Claudia-Pacori/Repositorio_Tesis_Pacori/README.md

# Repositorio de Trabajo de Investigación
Contenido de hardware y firmware para mi trabajo de investigación. 

Nombre: Claudia Pacori Palomino

Universidad de Ingeniería y Tecnología.

Lima, Perú - 2024.2
