Claudia-Pacori/Repositorio_Tesis_Pacori/01 Hardware/00 PCB/Producción/BOM_Tesis_nodo_PS.xlsx

Comment | Part | Footprint | Value | Designator
CC0603KRX7R9BB104 | C14663 | C0603 | 0.1uF | C1
CL10A106KP8NNNC | C19702 | C0603 | 10uF | C2
CC0603KRX7R9BB104 | C14663 | C0603 | 0.1uF | C3
CC0805KRX7R9BB104 | C49678 | C0805 | 0.1uF | C6
CL10A106KP8NNNC | C19702 | C0603 | 10uF | C7
CC0603KRX7R9BB104 | C14663 | C0603 | 0.1uF | C8
CC0603KRX7R9BB104 | C14663 | C0603 | 0.1uF | C11
CL31A106KBHNNNE | C13585 | C1206 | 10uF | C14
CL31A226KPHNNNE | C5672 | C1206 | 22uF | C15
CL10A475KO8NNNC | C19666 | C0603 | 4.7uF | C16
CC0603KRX7R9BB104 | C14663 | C0603 | 0.1uF | C17
CL10A475KO8NNNC | C19666 | C0603 | 4.7uF | C18
YLED0603B | C19171394 | LED-0603 | BLUE | D1
YLED0603B | C19171394 | LED-0603 | BLUE | D2
SS34 | C8678 | DO-214AC | SS34 | D3
PRTR5V0U2F,115 | C478118 | SOT886 | PRTR5V0U2F | D5
SS34 | C8678 | DO-214AC | SS34 | D7
TJ-S1615SW6TGLCCSRGB-A5 | C273611 | LED-0606 | TJ-S1615SW6TGLCCSRGB-A5 | D8
918-418K2023S40001 | C167321 | TYPE-C-SMD | USB-C FemaleConnector | J2
TFM201610ALM-R47MTAA | C501954 | 806 | 470nH | L1
25121WJ010KT4E | C419755 | R2512 | 0.1 | R1
0603WAF1002T5E | C25804 | R0603 | 10k | R2
0603WAF1002T5E | C25804 | R0603 | 10k | R3
0603WAF1002T5E | C25804 | R0603 | 10k | R4
0603WAF1002T5E | C25804 | R0603 | 10k | R5
0603WAF1002T5E | C25804 | R0603 | 10k | R6
0603WAF1503T5E | C22807 | R0603 | 150k | R7
0805W8F1002T5E | C17414 | R0805 | 10k | R9
0603WAF2200T5E | C22962 | R0603 | 220 | R10
0805W8F1002T5E | C17414 | R0805 | 10k | R11
0603WAF2200T5E | C22962 | R0603 | 220 | R12
0603WAF5113T5E | C23194 | R0603 | 511k | R13
0603WAJ0913T5E | C25610 | R0603 | 91k | R14
0603WAF1003T5E | C25803 | R0603 | 100k | R15
0603WAF5101T5E | C23186 | R0603 | 5.1k | R18
0603WAF5101T5E | C23186 | R0603 | 5.1k | R19
0603WAF1201T5E | C22765 | R0603 | 1.2k | R21
0603WAF2200T5E | C22962 | R0603 | 220 | R22
0603WAF2200T5E | C22962 | R0603 | 220 | R23
INA219BIDCNT | C2653868 | SOT23-8 | INA219BIDCNT | SENSORCORRIENTE
SKRKAEE020 | C115357 | SW-SMD-2_2.9x3.9x1.7 | SKRKAEE020 | SW1
SKRKAEE020 | C115357 | SW-SMD-2_2.9x3.9x1.7 | SKRKAEE020 | SW2
AO3401A | C15127 | SOT-23 | AO3401A | T1
SHT40-BD1B-R2 | C7461849 | SHT40BD1BR2 | SHT40-BD1B-R2 | TH
ESP32-WROOM-32E(16MB) | C701343 | ESP-WROOM-32D-NARROW | ESP-WROOM-32E | U2
CH340C | C84681 | SOP-16 | CH340C | U4
LMBT3904DW1T1G | C131781 | SOT-363 | MBT3904DW1T1 | U5
MAX17048G+T10 | C2682616 | TDFN-8_EP | MAX17048 | U7
TPS63802DLAR | C2845237 | VSON-10(2x3) | TPS63802DLAR | U11
TP4056-42-ESOP8 | C16581 | ESOP-8 | TP4056 | U13
