Claudia-Pacori/Repositorio_Tesis_Pacori/01 Hardware/01 Carcasa/Pieza_baja.stl

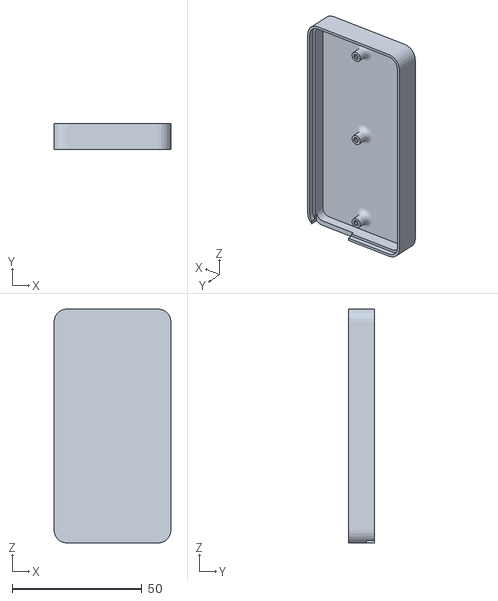
[picture p1: CAD file, 2024-10-21]
01 Hardware/01 Carcasa/Pieza_baja.stl
45.0 x 10.0 x 90.0
