Claudia-Pacori/Repositorio_Tesis_Pacori/01 Hardware/01 Carcasa/Pieza_superior.stl

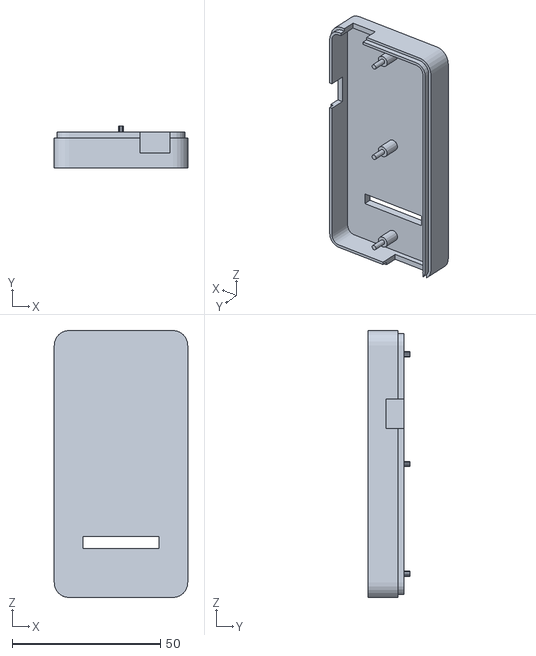
[picture p2: CAD file, 2024-10-21]
01 Hardware/01 Carcasa/Pieza_superior.stl
45.0 x 14.0 x 90.0
