Claudia-Pacori/Repositorio_Tesis_Pacori/(list of files, cad)

Other CAD files:
01 Hardware/01 Carcasa/Pieza_baja.ipt
01 Hardware/01 Carcasa/Pieza_superior.ipt
