Claudia-Pacori/Repositorio_Tesis_Pacori/01 Hardware/00 PCB/nodos_schematic.pdf

# TFM201610ALM-R47MTAA ADC¹ ADC² Boot Control

## VIN

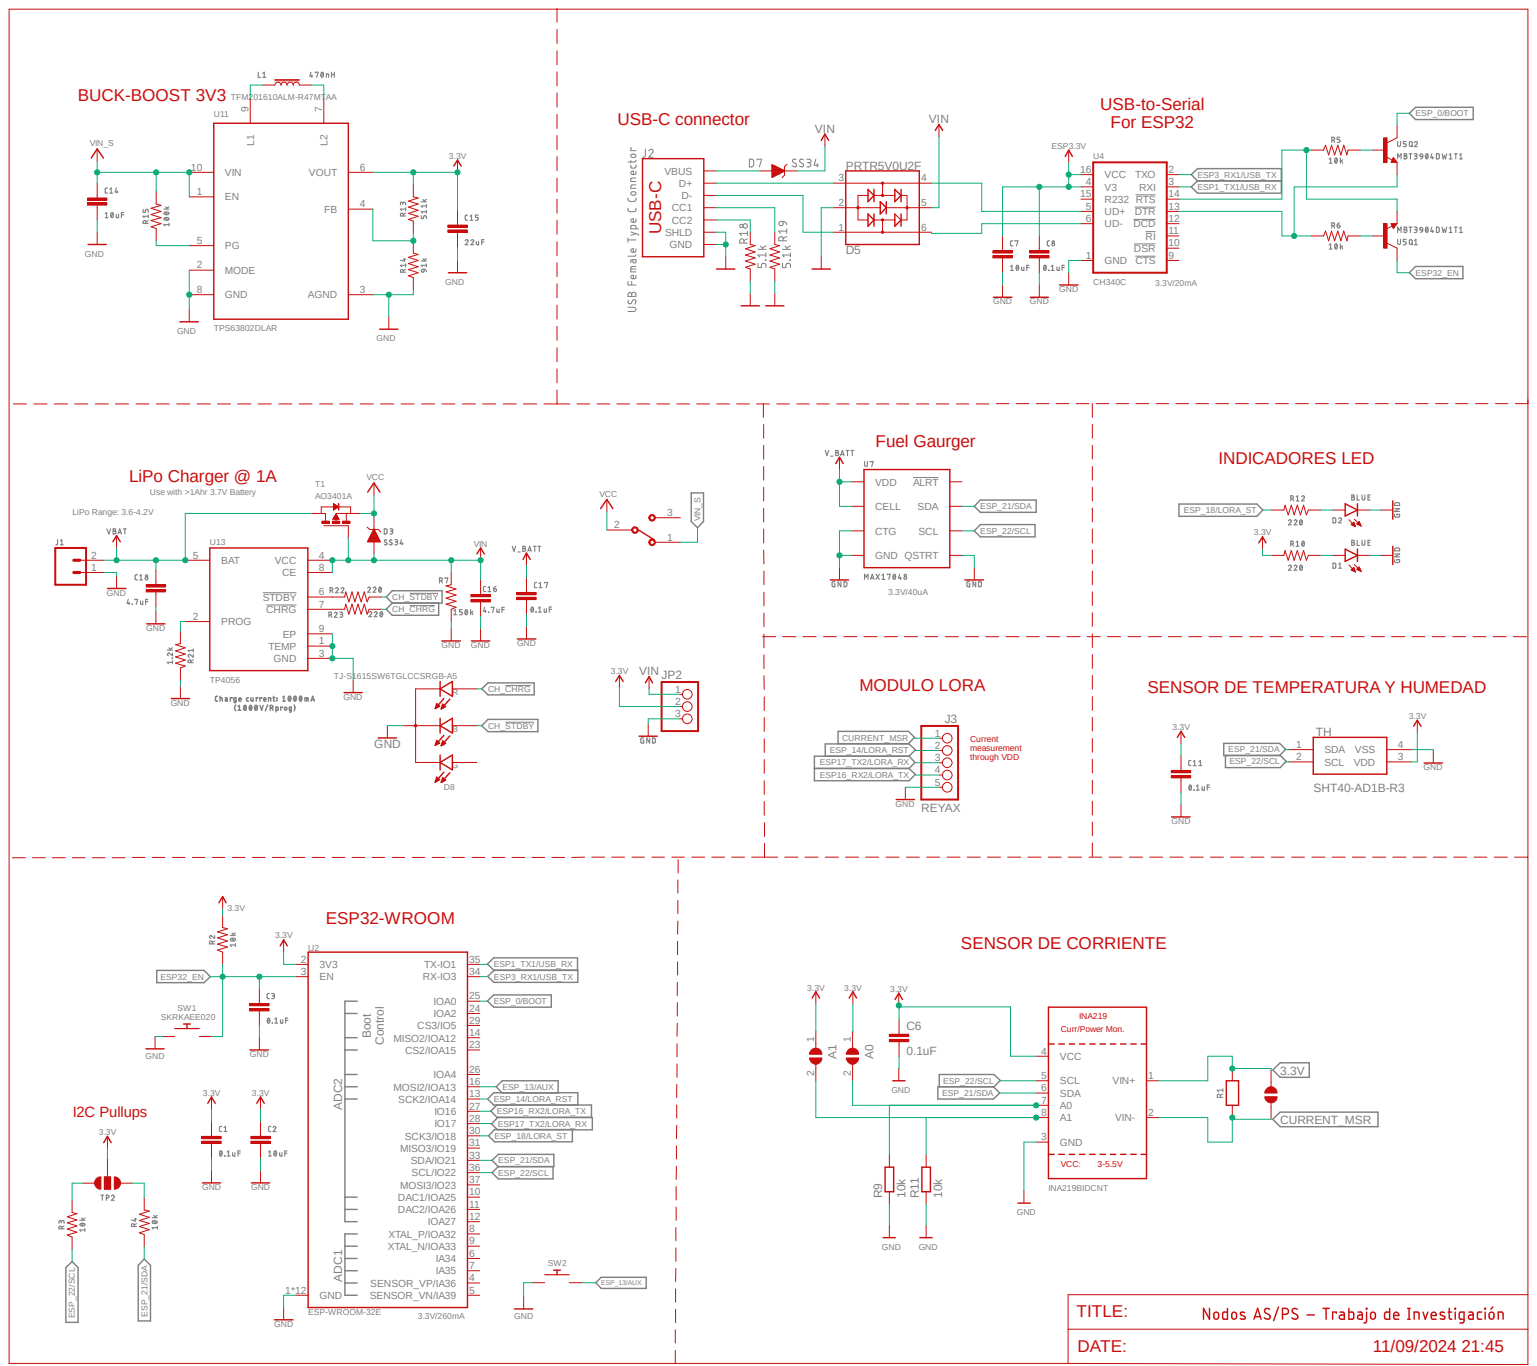
[picture p3: page 1]

SENSOR DE TEMPERATURA Y HUMEDAD
