Claudia-Pacori/Repositorio_Tesis_Pacori/01 Hardware/00 PCB/nodos_board.pdf

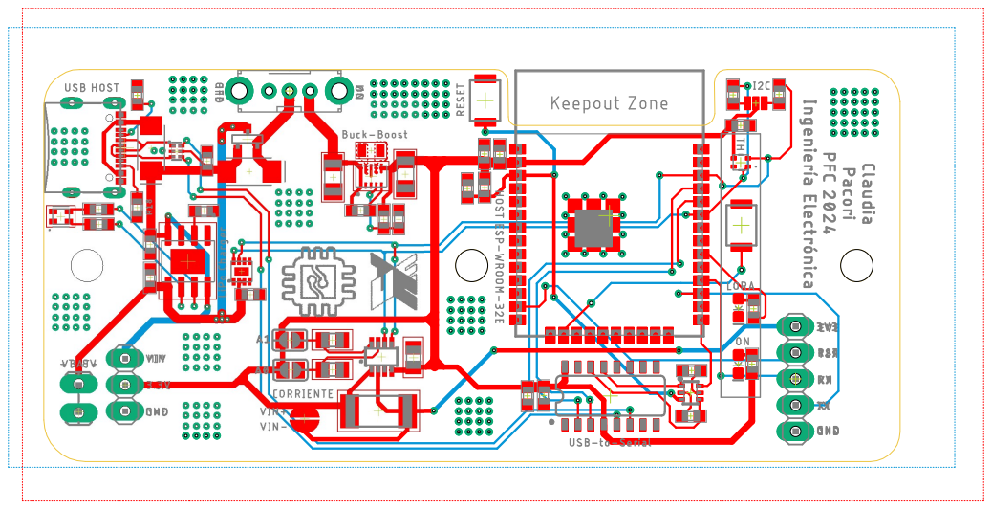
[picture p4: page 1]
