Claudia-Pacori/Repositorio_Tesis_Pacori/01 Hardware/00 PCB/nodo_PS.brd

## EAGLE design 01 Hardware/00 PCB/nodo_PS.brd (2024-10-21)

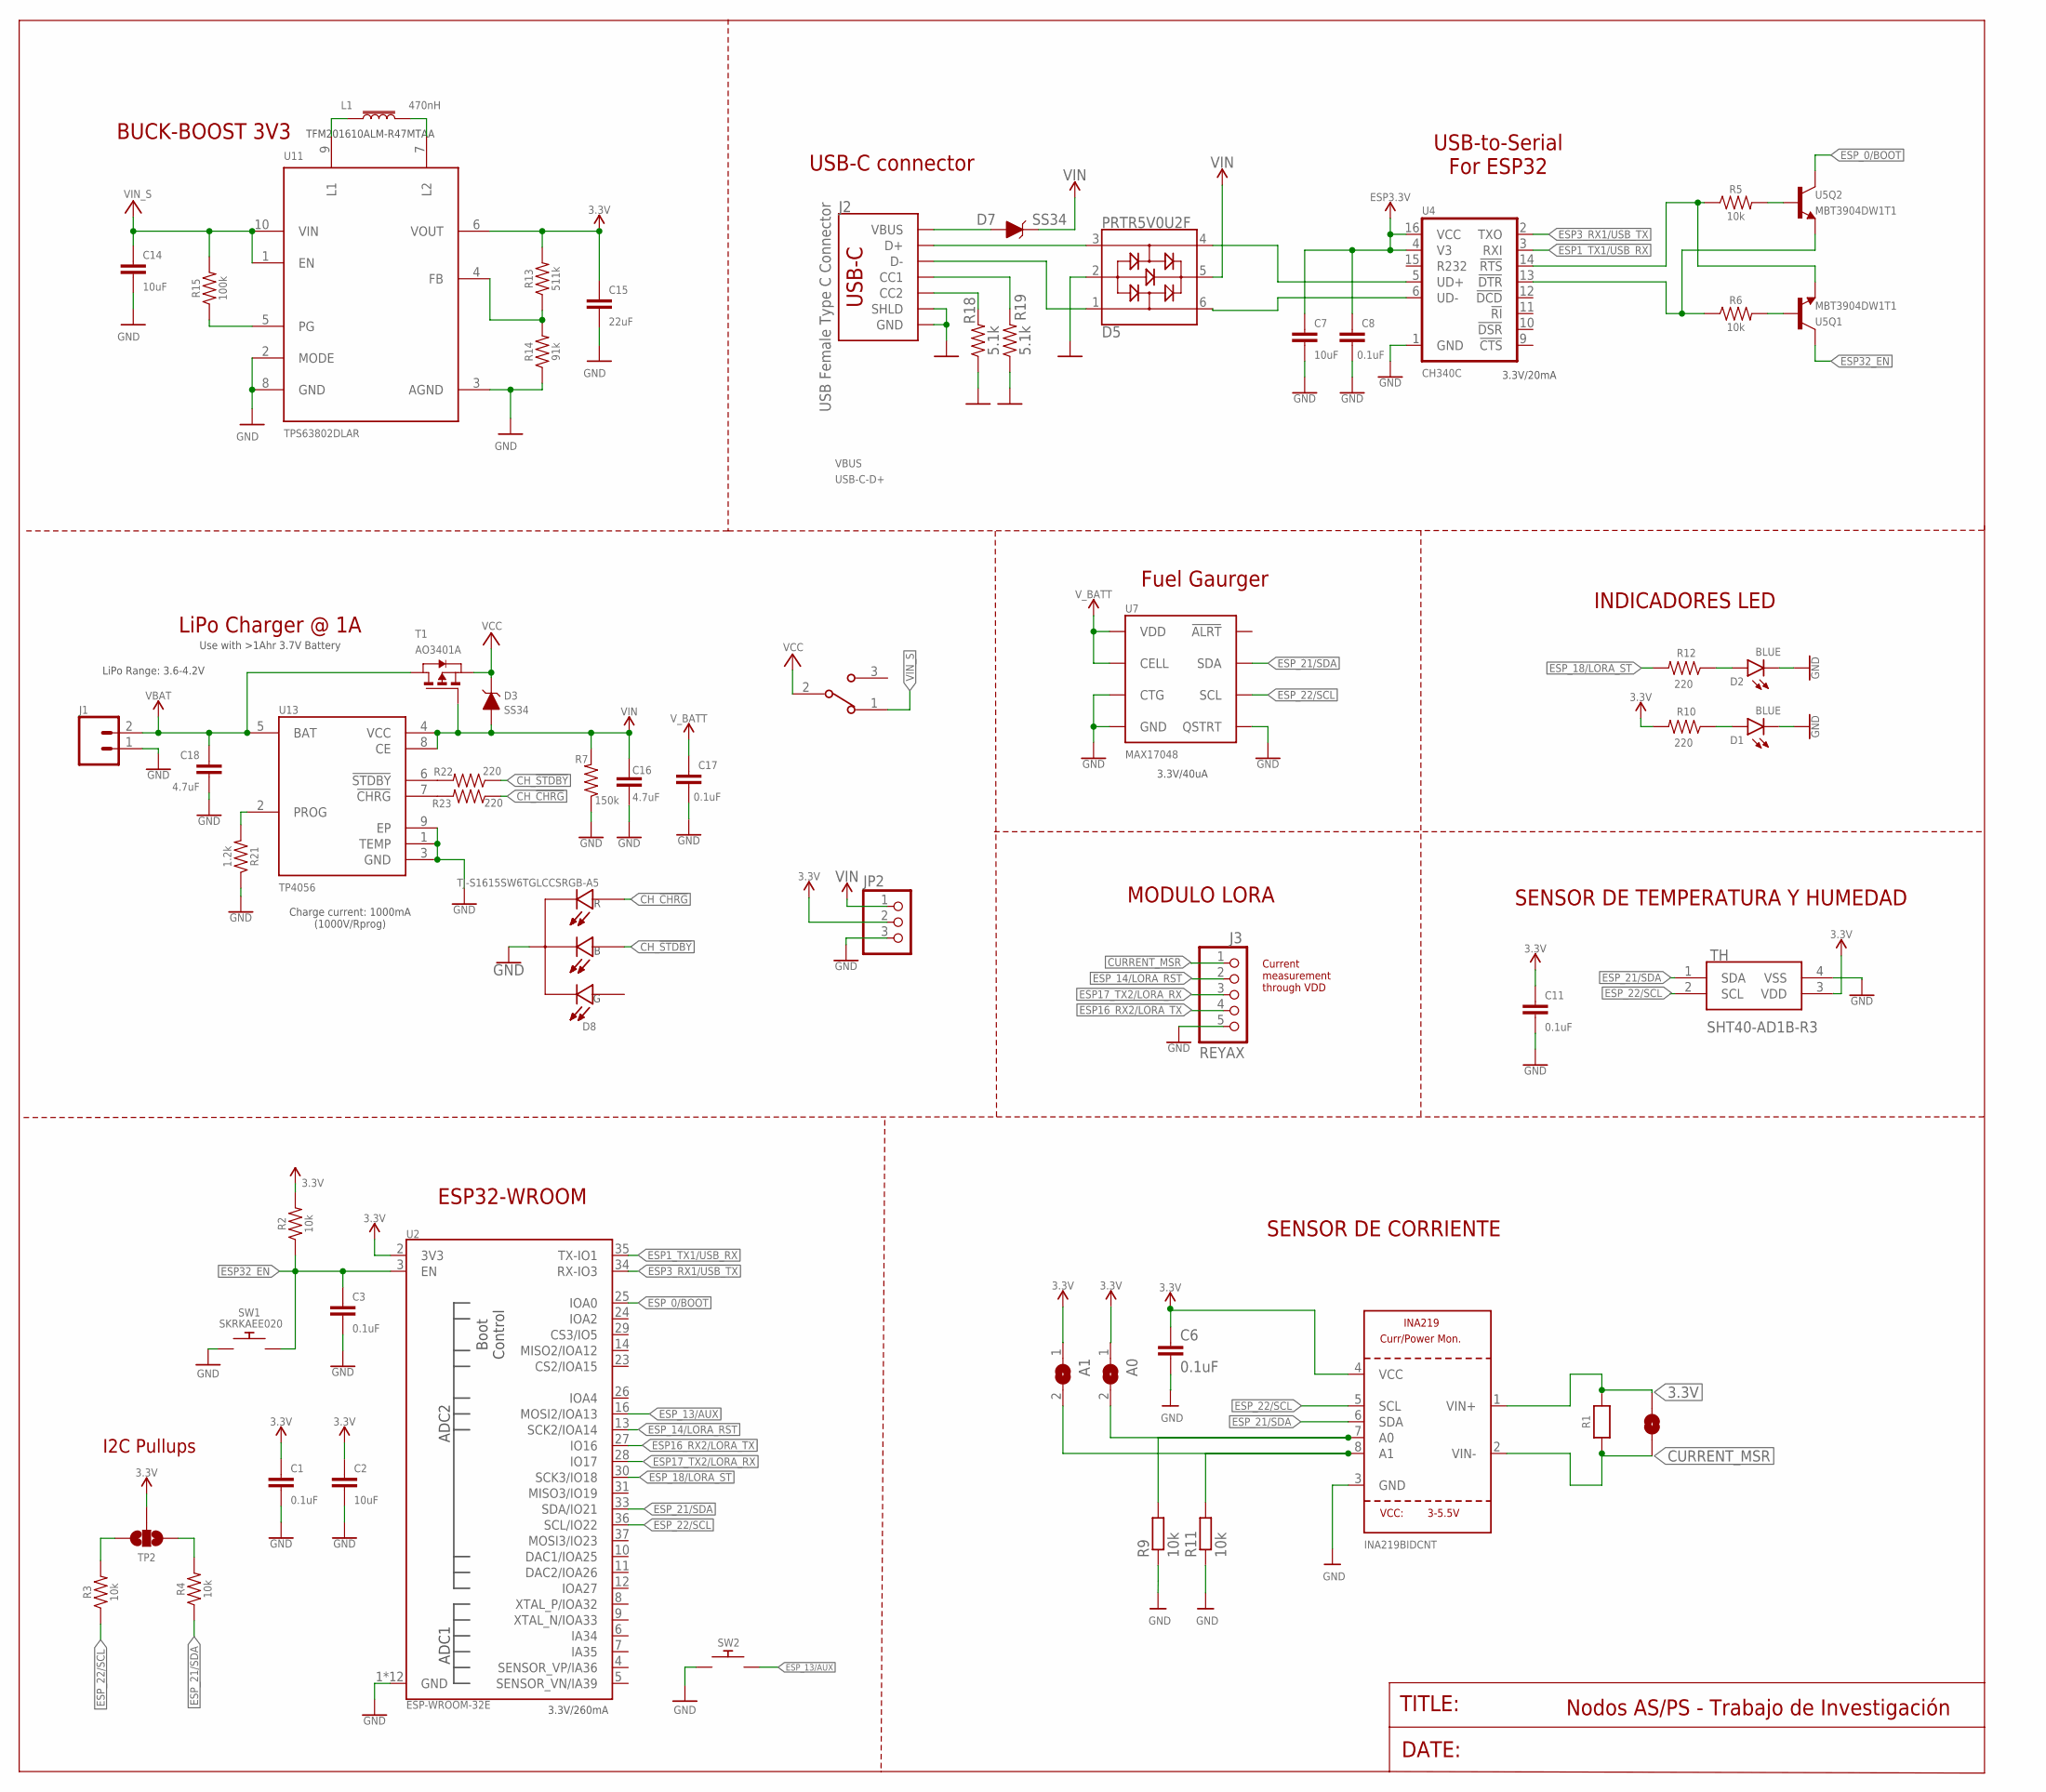
[picture p5: schematic nodo_PS.sch]

Parts:
A0, A1: SOLDERJUMPERREFLOW_NOPASTE; SOLDERJUMPER_REFLOW_NOPASTE
C1, C3, C8, C11, C17: 0.1uF; 0603
C2, C7: 10uF; 0603
C6: 0.1uF; C0805
C14: 10uF; 1206
C15: 22uF; 1206
C16, C18: 4.7uF; 0603
D1, D2: BLUE; LED-0603
D3, D7: SS34; DO-214AC
D5: PRTR5V0U2F; SOT886
D8: TJ-S1615SW6TGLCCSRGB-A5; LED_OSTB0603C1C
J1: CONN_02LOCK_LONGPADS; 1X02_LOCK_LONGPADS
J2: USB Female Type C Connector; USB-C-16P_4LAYER-PADS
J3: REYAX; 1X05
JP1: JUMPER-SMT_2_NO_NO-SILK_ROUND; SMT-JUMPER_2_NO_NO-SILK_ROUND
JP2: PINHD-1X3; 1X03
L1: 470nH; 0805
R1: 0.1/1% (PT2512FK-070R1L); 2512
R2, R3, R4, R5, R6: 10k; 0603
R7: 150k; 0603
R9, R11: 10k; R0805
R10, R12, R22, R23: 220; 0603
R13: 511k; 0603
R14: 91k; 0603
R15: 100k; 0603
R18, R19: 5.1k; 0603
R21: 1.2k; 0603
S1: EG1213; SW_EG1213
SENSORCORRIENTE: INA219BIDCNT; SOT23-8
SW1, SW2: SKRKAEE020
T1: AO3401A; SOT-23
TH: SHT40-AD1B-R3; SHT40AD1BR3
TP2: JUMPER-SMT_3_NO_NO-SILK; SMT-JUMPER_3_NO_NO-SILK
U2: ESP-WROOM-32E; ESP-WROOM-32D-NARROW
U4: CH340C; SO016
U5: MBT3904DW1T1; SC70-6
U7: MAX17048; DFN-8
U11: TPS63802DLAR; VREG_TPS63802DLAR
U13: TP4056; SOP127P600X175-9N

Connections:
3.3V: A0.1, A1.1, C1.1, C2.1, C6.1, C7.1, C8.1, C11.1, C15.1, JP1.1, JP2.2, R1.2, R2.2, R10.2, R13.2, SENSORCORRIENTE.1 (VIN+), SENSORCORRIENTE.4 (VCC), TH.3 (VDD), TP2.2, U2.2 (3V3), U4.4 (V3), U4.16 (VCC), U11.6 (VOUT)
ADDR0: A0.2, R9.2, SENSORCORRIENTE.7 (A0)
ADDR1: A1.2, R11.2, SENSORCORRIENTE.8 (A1)
CC1: J2.B5 (CC2), R18.2
CC2: J2.A5 (CC1), R19.2
CH_!CHRG: D8.3, R23.1
CH_!STDBY: D8.2, R22.1
CURRENT_MSR: J3.1, JP1.2, R1.1, SENSORCORRIENTE.2 (VIN-)
ESP1_TX1/USB_RX: U2.35 (TX-IO1), U4.3 (RXI)
ESP3_RX1/USB_TX: U2.34 (RX-IO3), U4.2 (TXO)
ESP16_RX2/LORA_TX: J3.4, U2.27 (IO16)
ESP17_TX2/LORA_RX: J3.3, U2.28 (IO17)
ESP32_!DTR: R6.1, U4.13 (!DTR), U5.1 (E)
ESP32_!RTS: R5.1, U4.14 (!RTS), U5.4 (E)
ESP32_EN: C3.1, R2.1, SW1.2, U2.3 (EN), U5.3 (C)
ESP_0/BOOT: U2.25 (IOA0), U5.6 (C)
ESP_13/AUX: SW2.2, U2.16 (MOSI2/IOA13)
ESP_14/LORA_RST: J3.2, U2.13 (SCK2/IOA14)
ESP_18/LORA_ST: R12.2, U2.30 (SCK3/IO18)
ESP_21/SDA: R4.1, SENSORCORRIENTE.6 (SDA), TH.1 (SDA), U2.33 (SDA/IO21), U7.8 (SDA)
ESP_22/SCL: R3.1, SENSORCORRIENTE.5 (SCL), TH.2 (SCL), U2.36 (SCL/IO22), U7.7 (SCL)
GND: C1.2, C2.2, C3.2, C6.2, C7.2, C8.2, C11.2, C14.2, C15.2, C16.2, C17.2, C18.2, D1.C, D2.C, D5.2, D8.4, J1.1, J2.GND, J2.GND2 (GND), J2.SHLD2 (SHLD), J2.SHLD3 (SHLD), J2.SHLD4 (SHLD), J2.SHLD5 (SHLD), J3.5, JP2.3, R7.1, R9.1, R11.1, R14.1, R18.1, R19.1, R21.1, SENSORCORRIENTE.3 (GND), SW1.1, SW2.1, TH.4 (VSS), U2.1 (GND), U2.15 (GND), U2.38 (GND), U2.GND1 (GND), U2.GNDT1 (GND), U2.GNDT2 (GND), U2.GNDT3 (GND), U2.GNDT4 (GND), U2.GNDT5 (GND), U2.GNDT6 (GND), U2.GNDT7 (GND), U2.GNDT8 (GND), U4.1 (GND), U7.1 (CTG), U7.4 (GND), U7.6 (QSTRT), U7.9 (GND), U11.2 (MODE), U11.3 (AGND), U11.8 (GND), U13.1 (TEMP), U13.3 (GND), U13.9 (EP)
unnamed: D5.1, J2.A7 (D-), J2.B7 (D-)
unnamed: D5.4, U4.5 (UD+)
unnamed: D5.6, U4.6 (UD-)
unnamed: D1.A, R10.1
unnamed: D2.A, R12.1
unnamed: L1.1, U11.9 (L1)
unnamed: L1.2, U11.7 (L2)
unnamed: R22.2, U13.6 (!STDBY)
unnamed: R13.1, R14.2, U11.4 (FB)
unnamed: R23.2, U13.7 (!CHRG)
unnamed: R3.2, TP2.3
unnamed: R4.2, TP2.1
unnamed: R15.1, U11.5 (PG)
unnamed: R6.2, U5.5 (B)
unnamed: R5.2, U5.2 (B)
unnamed: R21.2, U13.2 (PROG)
USB-C-D+: D5.3, J2.A6 (D+), J2.B6 (D+)
VBAT: C17.1, C18.1, J1.2, T1.1 (D), U7.2 (CELL), U7.3 (VDD), U13.5 (BAT)
VBUS: D7.A, J2.VBUS1 (VBUS), J2.VBUS2 (VBUS)
VCC: D3.C, S1.2, T1.2 (S)
VIN: C16.1, D3.A, D5.5, D7.C, JP2.1, R7.2, T1.3 (G), U13.4 (VCC), U13.8 (CE)
VIN_S: C14.1, R15.2, S1.1, U11.1 (EN), U11.10 (VIN)

Notes on the sheet:
ESP32-WROOM
3.3V/260mA
SENSOR DE TEMPERATURA Y HUMEDAD
SENSOR DE CORRIENTE
USB-to-Serial For ESP32
3.3V/20mA
USB-C connector
LiPo Range: 3.6-4.2V
Charge current: 1000mA (1000V/Rprog)
Use with >1Ahr 3.7V Battery
LiPo Charger @ 1A
Fuel Gaurger
3.3V/40uA
Nodos AS/PS - Trabajo de Investigación
TITLE:
DATE:
BUCK-BOOST 3V3
TFM201610ALM-R47MTAA
INDICADORES LED
I2C Pullups
MODULO LORA
Current measurement through VDD

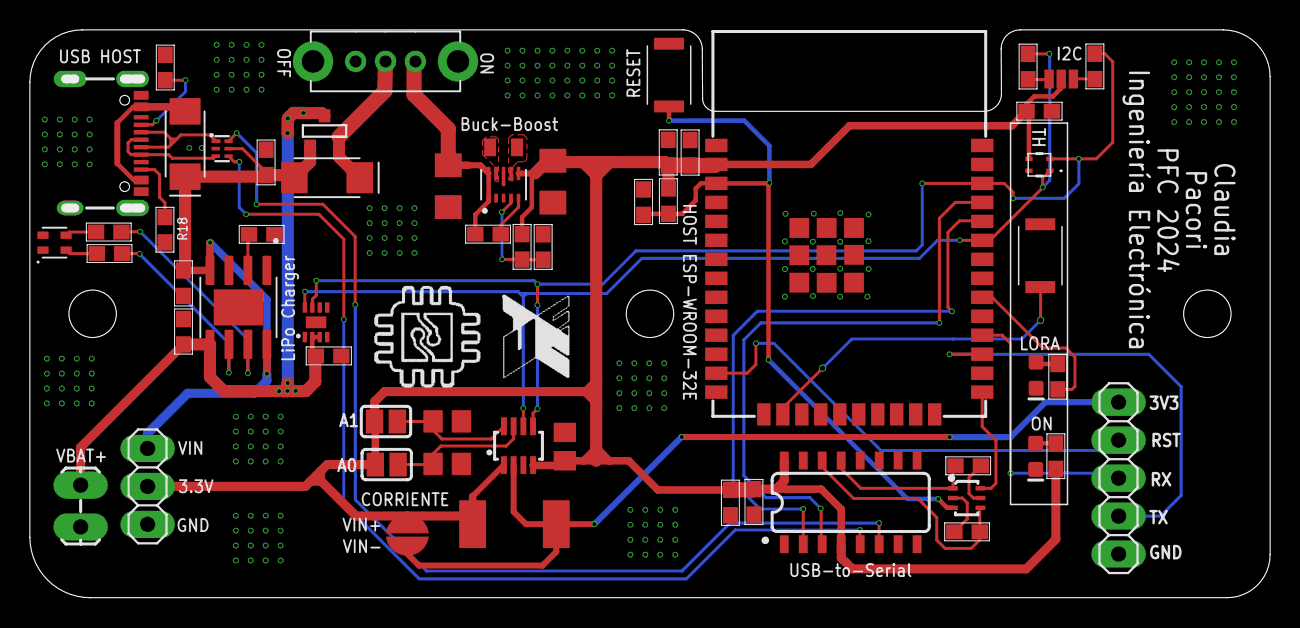
[picture p6: board nodo_PS.brd from above]

Board: 2 copper layers, 83.0 x 38.0 mm, 58 parts (0 on the bottom side), 44 nets.
