Claudia-Pacori/Repositorio_Tesis_Pacori/02 Firmware/nodo_AS/lora.ino

String myAddress = "2";
String otherAddress = "1";

void sendLoRa(String comando, bool mostrar = false)
{
    if (mostrar)
    {
        //Serial.println(comando);

        LoRaSerial.print(comando + "\r\n");
        unsigned long startTime = millis();

        while (millis() - startTime < 100) // verify answer from the module
        {
            if (LoRaSerial.available())
            {
                String response = LoRaSerial.readString();
                //Serial.println("Response: " + response);
                break;
            }
        }
    }
    else
    {
        LoRaSerial.print(comando + "\r\n");
    }
}

void sendMessage(String message)
{
    sendLoRa("AT+SEND=" + otherAddress + "," + String(message.length()) + "," + message, true);
}

void sendConfirmation() {
    delay(3500);
    safeConfig();
    String message = "CONFIRM|TP" + String(TPeval) + "|SF" + String(SFeval) + "|CR" + String(CReval);
    sendMessage(message);
    sendMessage(message);
    sendMessage(message);
}

void setParameter(int SF = 9, int CR = 4, int TP = 22)
{
    sendLoRa("AT+PARAMETER=" + String(SF) + ",9," + String(CR) + ",12", true); // SF, 500 KHz, CR, Preamble 12
    sendLoRa("AT+CRFOP=" + String(TP), true);
}

void safeConfig()
{
    setParameter();
}

void beginLoRa()
{
    sendLoRa("AT+ADDRESS=" + myAddress, true); // NODO PS ADDRESS: 1
    sendLoRa("AT+NETWORKID=1", true);
    safeConfig();
}
