Claudia-Pacori/Repositorio_Tesis_Pacori/02 Firmware/nodo_AS/system.ino

#define AuxBUTpin 13
#define AuxLEDpin 18

void initialize()
{
    beginLoRa();

    pinMode(AuxBUTpin, INPUT);
    pinMode(AuxLEDpin, OUTPUT);
    digitalWrite(AuxLEDpin, LOW);
}
