Claudia-Pacori/Repositorio_Tesis_Pacori/(commit log)

2024-05-31 hardware files
    [mod_sens.brd, mod_sens.sch, nodo_AS.brd, nodo_AS.sch, nodo_PS.brd, nodo_PS.sch]
2024-09-16 actualizacion de archivos 24-2
    [mod_sens.brd, mod_sens.sch, nodo_AS.brd, nodo_AS.sch, nodo_PS.brd, nodo_PS.sch]
2024-10-21 actualización de archivos. HW final, FW v1
    [BOM_Tesis_nodo_PS.xlsx, Pieza_baja.ipt, Pieza_baja.stl, Pieza_superior.ipt, Pieza_superior.stl, nodo_PS.brd, nodo_PS.sch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]
